danielvail44/Cubesat-Reaction-Wheel/README.md

# Cubesat-Reaction-Wheel
Low Cost Cubesat Reaction Wheel
