danielvail44/Cubesat-Reaction-Wheel/RW_board/RW_board_BOM.xlsx

Reference | Value | Datasheet | Footprint | Qty | Order Qty | Manufacturer_Part_Number | Mouser Part Number | Voltage rating | DKPN | Alt Link | Cart Links
C201,C202,C211,C212,C213 | 10u | ~ | Capacitor_SMD:C_0603_1608Metric | 5 | 15 | GRM188R6YA106MA73D | 81-GRM188R6YA106MA3D | 35V | 490-13248-1-ND | . | https://www.mouser.com/ProjectManager/ProjectDetail.aspx?AccessID=6e81cea3ba
C203,C206,C214,C303,C308,C405 | 1u | ~ | Capacitor_SMD:C_0402_1005Metric | 6 | 18 | GRM155R6YA105KE11J | 81-GRM155R6YA105KE1J | 35V | 490-GRM155R6YA105KE11JCT-ND | . | https://www.digikey.com/short/zz49hznb
C204,C207,C210,C215,C216,C217,C218,C305,C307,C401,C407,C408,C409,C410 | 100n | ~ | Capacitor_SMD:C_0402_1005Metric | 14 | 42 | GRM155R61H104KE19J | 81-GRM155R61H104KE9J | 35V | 490-GRM155R61H104KE19JCT-ND | .
C205 | 10n | ~ | Capacitor_SMD:C_0402_1005Metric | 1 | 10 | GCM155R71H103KA55J | 81-GCM155R71H103KA5J | 35V | 490-13295-1-ND | .
C208 | 1n | ~ | Capacitor_SMD:C_0402_1005Metric | 1 | 10 | GCM1555C1H102GA16J | 81-GCM1555C1H102GA6J | 35V | 490-GCM1555C1H102GA16JCT-ND | .
C209 | 10p | ~ | Capacitor_SMD:C_0402_1005Metric | 1 | 10 | GCM1555C1H100JA16D | 81-GCM1555C1H100JA6D | 35V | 490-10668-1-ND | .
C219,C406 | 4.7u | ~ | Capacitor_SMD:C_0402_1005Metric | 2 | 10 | GRM155R61A475MEAAD | 81-GRM155R61A475MEAD | 35V | 490-14306-1-ND | .
C301,C302,C304,C309 | 22uF | ~ | Capacitor_SMD:C_0805_2012Metric | 4 | 12 | C2012X5R1V226M125AC | 810-C2012X5R1V226MAC | 35V | 445-14428-1-ND | .
C306 | 47n | ~ | Capacitor_SMD:C_0402_1005Metric | 1 | 10 | GRM155R61H473KE19D | 81-GRM155R61H473KE9D | 35V | 490-12705-1-ND | .
C402 | 4.7n | ~ | Capacitor_SMD:C_0402_1005Metric | 1 | 10 | GRM155R71H472JA01D | 81-GRM155R71H472JA1D | 35V | 490-7764-1-ND | .
C403,C404 | 20p | ~ | Capacitor_SMD:C_0402_1005Metric | 2 | 10 | GRM1555C1H200JA01D | 81-GRM1555C1H200JA1D |  | 490-5930-1-ND | .
D201 | SDM2U30CSP-7 | https://www.diodes.com//assets/Datasheets/SDM2U30CSP.pdf | X3-WLB1608-2 | 1 | 2 | SDM2U30CSP-7 | 621-SDM2U30CSP-7 |  | SDM2U30CSP-7DICT-ND | .
D301 | BLUE | ~ | LED_SMD:LED_0603_1608Metric | 1 | 3 | 475-KBEELP41.12-P1R2-36-3X4X-5-R18CT-ND | 720-P4112P1R2363X4X5 |  | 475-KBEELP41.12-P1R2-36-3X4X-5-R18CT-ND | .
D302 | GREEN | ~ | LED_SMD:LED_0603_1608Metric | 1 | 3 | KT EELP41.12-S2U1-25-2X4X-5-R18 | 720-P4112S2U1252X4X5 |  | 475-KTEELP41.12-S2U1-25-2X4X-5-R18CT-ND | .
D303,D402 | YELLOW | ~ | LED_SMD:LED_0603_1608Metric | 2 | 3 | KY EELP41.22 Q2T1-36-A8J8-020-R18 | 720-P412Q2T136A8J802 |  | 475-KYEELP41.22Q2T1-36-A8J8-020-R18CT-ND | .
D304 | RED | ~ | LED_SMD:LED_0603_1608Metric | 1 | 3 | KS EELP41.22-P1R2-58-A8J8-020-R18 | 720-P412P1R258A8J802 |  | 475-KSEELP41.22-P1R2-58-A8J8-020-R18CT-ND | .
D401,D403 | PRTR5V0U2X,215 | https://assets.nexperia.com/documents/data-sheet/PRTR5V0U2X.pdf | PRTR5V0U2X | 2 | 4 | PRTR5V0U2X,215 | 771-PRTR5V0U2X-T/R |  | 1727-3884-1-ND | .
IC201 | MAX44284WAUT+T | https://datasheets.maximintegrated.com/en/ds/MAX44284.pdf | SOT95P280X145-6N | 1 | 2 | MAX44284WAUT+T | 700-MAX44284WAUT+T |  | 175-MAX44284WAUT+TCT-ND | .
IC301 | MCT8316Z0RQRGFRQ1 | https://www.ti.com/lit/ds/symlink/mct8316z-q1.pdf?ts=1673673589164 | QFN50P500X700X100-41N-D | 1 | 2 | MCT8316Z0RQRGFRQ1 | 595-CT8316Z0RQRGFRQ1 |  | 296-MCT8316Z0RQRGFRQ1CT-ND | .
J1 | Conn_01x08_Pin | ~ | Connector_Molex:Molex_PicoBlade_53048-0810_1x08_P1.25mm_Horizontal | 1 | 2 | 53048-0810 | 538-53048-0810 |  | WM1748-ND | .
J2 | 1-84953-1 | https://www.te.com/commerce/DocumentDelivery/DDEController?Action=showdoc | 1849531 | 1 | 2 | 1-84953-1 | 571-1-84953-1 |  | A101403CT-ND | .
J401 | USB4105-GF-A |  | RW_Imports:GCT_USB4105-GF-A | 1 | 2 | USB4105-GF-A | 640-USB4105-GF-A |  | 2073-USB4105-GF-ACT-ND | .
J402 | 20021521-00010T4LF | https://cdn.amphenol-cs.com/media/wysiwyg/files/drawing/20021521.pdf | 2002152100010T4LF | 1 | 2 | 20021521-00010T4LF | 649-221521-00010T4LF |  | 609-6534-ND | .
L301 | BCL322515RT-470M-D | https://product.tdk.com/system/files/dam/doc/product/inductor/inductor/smd/catalog/inductor_automotive_power_bcl322515rt-d_en.pdf | RW_Imports:INDPM3225X150N | 1 | 2 | BCL322515RT-470M-D | 810-BCL322515RT470MD |  | 445-BCL322515RT-470M-DCT-ND | .
R1 | 20 | ~ | Resistor_SMD:R_0402_1005Metric | 1 | 10 | 560112110083 | 710-560112110083 |  | 732-560112110083CT-ND | .
R101,R202,R305,R308,R402 | 10k | ~ | Resistor_SMD:R_0402_1005Metric | 5 | 15 | 560112110020 | 710-560112110020 |  | 732-560112110020CT-ND | .
R102,R212,R214,R408 | 1k | ~ | Resistor_SMD:R_0402_1005Metric | 4 | 12 | 560112110012 | 710-560112110012 |  | 732-560112110012CT-ND | .
R201 | 16k | ~ | Resistor_SMD:R_0402_1005Metric | 1 | 10 | 560112110032 | 710-560112110032 |  | 732-560112110032CT-ND | .
R203 | 3.01k | ~ | Resistor_SMD:R_0402_1005Metric | 1 | 10 | CRT0402-FZ-3011GLF | 652-CRT0402FZ3011GLF |  | 311-3.01KLRCT-ND | .
R204 | 1.1k | ~ | Resistor_SMD:R_0402_1005Metric | 1 | 10 | 560112110185 | 710-560112110185 |  | 732-560112110185CT-ND | .
R205 | 6.9k | ~ | Resistor_SMD:R_0402_1005Metric | 1 | 10 | RT0402BRD076K9L | 71-TNPW04026K90BEED |  | 541-4510-1-ND | .
R206 | 100 | ~ | Resistor_SMD:R_0402_1005Metric | 1 | 10 | 560112110022 | 710-560112110022 |  | 732-560112110022CT-ND | .
R207 | 390m | ~ | Resistor_SMD:R_0805_2012Metric | 1 | 10 | RL1220S-R39-F | 754-RL1220S-R39-F |  | RL12S.39FCT-ND | .
R208,R210 | 24k | ~ | Resistor_SMD:R_0402_1005Metric | 2 | 10 | 560112110178 | 710-560112110178 |  | 311-24KJRCT-ND | .
R209 | 1.33k | ~ | Resistor_SMD:R_0402_1005Metric | 1 | 10 | CRT0402-FZ-1331GLF | 652-CRT0402FZ1331GLF |  | 311-1.33KLRCT-ND | .
R211 | 3.65k | ~ | Resistor_SMD:R_0402_1005Metric | 1 | 10 | 560112110116 | 710-560112110116 |  | 732-560112110116CT-ND | .
R213 | 20m | ~ | Resistor_SMD:R_0603_1608Metric | 1 | 10 | PE0603DRF570R02L | 603-PE0603DRF570R02L |  | 13-PE0603DRF570R02LCT-ND | .
R302,R303,R304,R401,R405 | 5.1k | ~ | Resistor_SMD:R_0402_1005Metric | 5 | 15 | CR0402-FX-5101GLF | 652-CR0402FX-5101GLF |  | CR0402-FX-5101GLFCT-ND | .
R306,R307,R309,R403,R406 | 330R | ~ | Resistor_SMD:R_0402_1005Metric | 5 | 15 | 560112110231 | 710-560112110231 |  | 732-560112110231CT-ND | .
R404 | 1M | ~ | Resistor_SMD:R_0402_1005Metric | 1 | 10 | 560112110033 | 710-560112110033 |  | 732-560112110033CT-ND | .
R407 | 39R | ~ | Resistor_SMD:R_0402_1005Metric | 1 | 10 | 560112110014 | 710-560112110014 |  | 732-560112110014CT-ND | .
SW401 | SW_Push | ~ | Button_Switch_SMD:SW_SPST_FSMSM | 1 | 2 | RS282G05A3SMRT | 611-RS-282G05A3-SMRT |  | CKN10384CT-ND | .
U201 | LM5022MM | http://www.ti.com/lit/ds/symlink/lm5022.pdf | Package_SO:MSOP-10_3x3mm_P0.5mm | 1 | 2 | LM5022MMX/NOPB | 926-LM5022MMX/NOPB |  | 296-LM5022MMX/NOPBCT-ND | .
U401 | ATSAMD21G18A-M | http://ww1.microchip.com/downloads/en/DeviceDoc/SAM_D21_DA1_Family_Data%20Sheet_DS40001882E.pdf | Package_DFN_QFN:QFN-48-1EP_7x7mm_P0.5mm_EP5.15x5.15mm | 1 | 2 | ATSAMD21G18A-MUT | 556-ATSAMD21G18A-MUT |  | ATSAMD21G18A-MUTCT-ND | .
Y401 | 830105946101 | https://www.mouser.tw/datasheet/2/445/830105946101-2005497.pdf | 830105946101 | 1 | 2 | 830105946101 | 710-830105946101 |  | 1923-830105946101CT-ND | .
L201 | XGL4040-223MEC |  | RW_Imports:IND_XGL4040-223MEC | 1 | 2 | XGL4040-223 |  |  | 2457-XGL4040-223MEC-ND | https://www.coilcraft.com/en-us/products/power/shielded-inductors/molded-inductor/xgl/xgl4040/xgl4040-223/
Q201 | BSZ300N15NS5ATMA1 | https://www.arrow.com/en/products/bsz300n15ns5atma1/infineon-technologies-ag | BSZ300N15NS5ATMA1 | 1 | 2 | BSZ300N15NS5ATMA1 |  |  | BSZ300N15NS5ATMA1CT-ND | https://www.rocelec.com/part/01tRl000007YmmJIAS-NCP1117DT12RKG
