danielvail44/Cubesat-Reaction-Wheel/CAD/ECX flat 22.stp

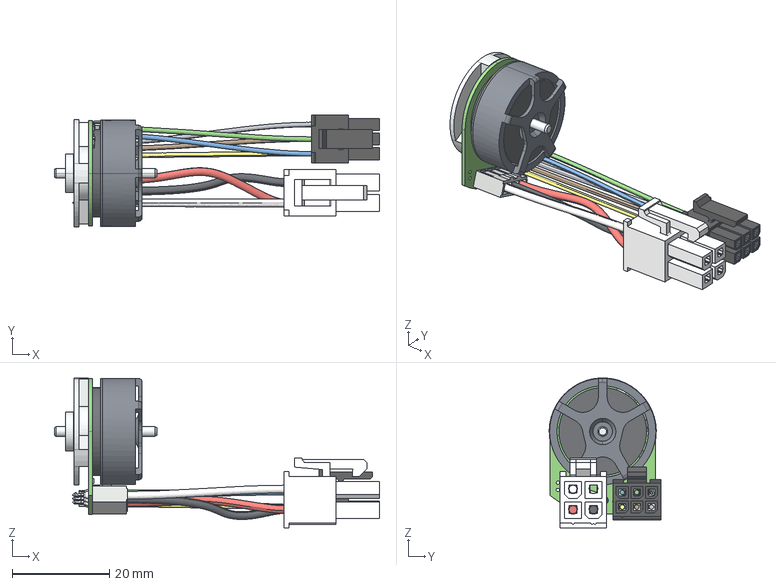
[picture p1: CAD file, 2025-01-22]
CAD/ECX flat 22.stp
66.7 x 22.9 x 30.8 mm
