danielvail44/Cubesat-Reaction-Wheel/(list of files, cad)

Other CAD files:
CAD/motor_pcb_drawing.dwg
CAD/OldVersions/motor_drawing.0001.dwg
