danielvail44/Cubesat-Reaction-Wheel/RW_board/RW_board.kicad_pcb

## KiCad design RW_board/RW_board.kicad_pcb (2025-02-06)

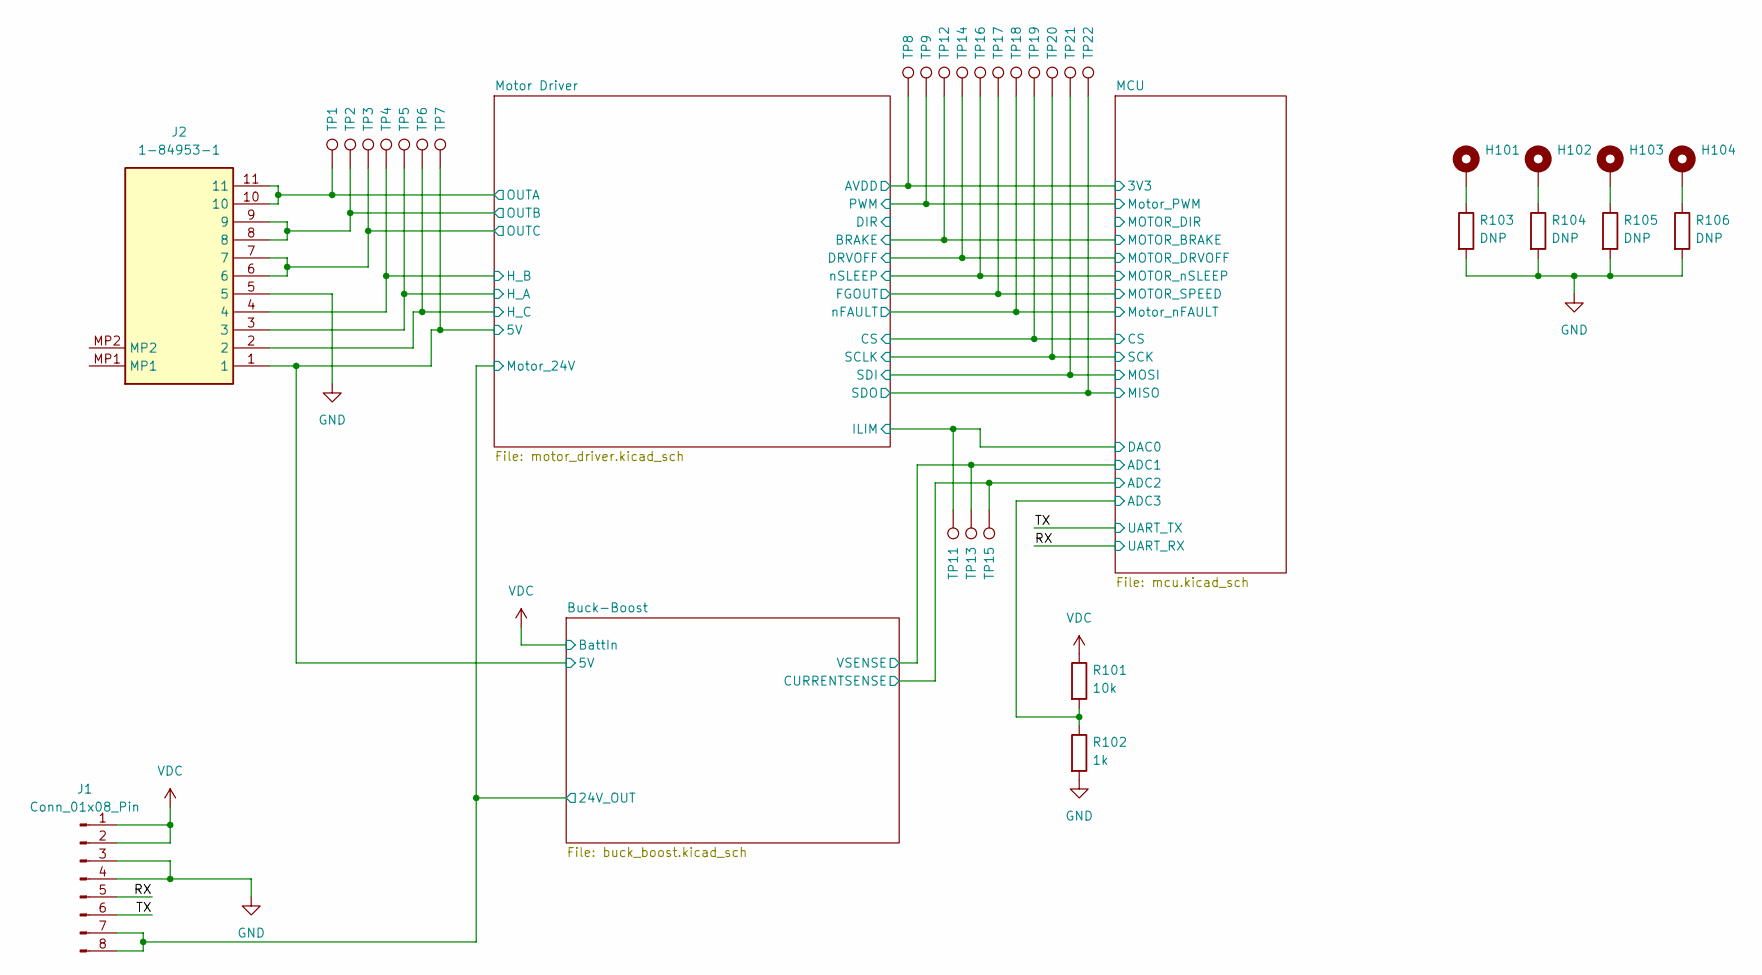
[picture p2: schematic RW_board.kicad_sch]

Parts:
H101, H102, H103, H104: MountingHole_Pad; MountingHole_3.4mm_Pad
J1: Conn_01x08_Pin; Molex_PicoBlade_53048-0810_1x08_P1.25mm_Horizontal; Mouser Part Number 538-53048-0810
J2: 1-84953-1; 1849531; Mouser Part Number 571-1-84953-1
R101: 10k; R_0402_1005Metric; Mouser Part Number 710-560112110020
R102: 1k; R_0402_1005Metric; Mouser Part Number 710-560112110012
R103, R104, R105, R106: DNP; R_0402_1005Metric
TP1, TP2, TP3, TP4, TP5, TP6, TP7, TP8, TP9, TP11, TP12, TP13, TP14, TP15, TP16, TP17, TP18, TP19, TP20, TP21, TP22: TestPoint; TestPoint_Pad_1.0x1.0mm

Connections:
+3.3V: TP8.1; also elsewhere on the board
/Buck-Boost/24V_OUT: J1.7, J1.8; also elsewhere on the board
/Buck-Boost/CURRENTSENSE: TP15.1; also elsewhere on the board
/Buck-Boost/VSENSE: TP13.1; also elsewhere on the board
/MCU/ADC3: R101.2, R102.1; also elsewhere on the board
/MCU/CS: TP19.1; also elsewhere on the board
/MCU/DAC0: TP11.1; also elsewhere on the board
/MCU/MISO: TP22.1; also elsewhere on the board
/MCU/MOSI: TP21.1; also elsewhere on the board
/MCU/MOTOR_BRAKE: TP12.1; also elsewhere on the board
/MCU/MOTOR_DRVOFF: TP14.1; also elsewhere on the board
/MCU/MOTOR_SPEED: TP17.1; also elsewhere on the board
/MCU/MOTOR_nSLEEP: TP16.1; also elsewhere on the board
/MCU/Motor_PWM: TP9.1; also elsewhere on the board
/MCU/Motor_nFAULT: TP18.1; also elsewhere on the board
/MCU/SCK: TP20.1; also elsewhere on the board
/Motor Driver/FB_BK: J2.1, TP7.1; also elsewhere on the board
/Motor Driver/H_A: J2.3, TP5.1; also elsewhere on the board
/Motor Driver/H_B: J2.4, TP4.1; also elsewhere on the board
/Motor Driver/H_C: J2.2, TP6.1; also elsewhere on the board
/Motor Driver/OUTA: J2.10, J2.11, TP1.1; also elsewhere on the board
/Motor Driver/OUTB: J2.8, J2.9, TP2.1; also elsewhere on the board
/Motor Driver/OUTC: J2.6, J2.7, TP3.1; also elsewhere on the board
/RX: J1.5; also elsewhere on the board
/TX: J1.6; also elsewhere on the board
GND: J1.3, J1.4, J2.5, R102.2, R103.2, R104.2, R105.2, R106.2; also elsewhere on the board
unnamed: H101.1, R103.1
unnamed: H102.1, R104.1
unnamed: H103.1, R105.1
unnamed: H104.1, R106.1
VDC: J1.1, J1.2, R101.1; also elsewhere on the board

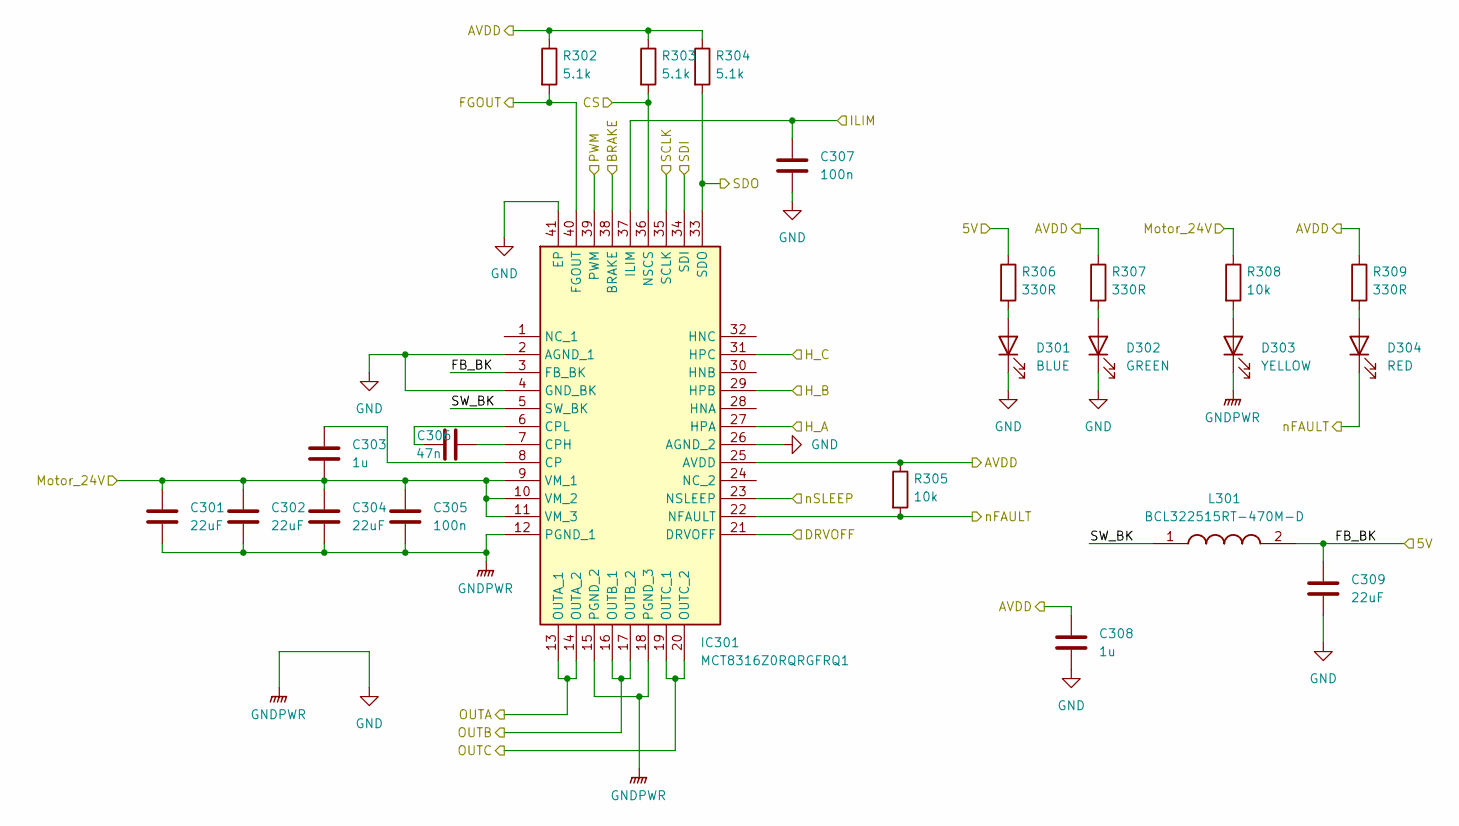
[picture p3: schematic motor_driver.kicad_sch]

Parts:
C301, C302, C304, C309: 22uF; C_0805_2012Metric; Voltage rating 35V; Mouser Part Number 810-C2012X5R1V226MAC
C303, C308: 1u; C_0402_1005Metric; Voltage rating 35V; Mouser Part Number 81-GRM155R6YA105KE1J
C305, C307: 100n; C_0402_1005Metric; Voltage rating 35V; Mouser Part Number 81-GRM155R61H104KE9J
C306: 47n; C_0402_1005Metric; Voltage rating 35V; Mouser Part Number 81-GRM155R61H473KE9D
D301: BLUE; LED_0603_1608Metric; Mouser Part Number 720-P4112P1R2363X4X5
D302: GREEN; LED_0603_1608Metric; Mouser Part Number 720-P4112S2U1252X4X5
D303: YELLOW; LED_0603_1608Metric; Mouser Part Number 720-P412Q2T136A8J802
D304: RED; LED_0603_1608Metric; Mouser Part Number 720-P412P1R258A8J802
IC301: MCT8316Z0RQRGFRQ1; QFN50P500X700X100-41N-D; Mouser Part Number 595-CT8316Z0RQRGFRQ1
L301: BCL322515RT-470M-D; INDPM3225X150N; Mouser Part Number 810-BCL322515RT470MD
R302, R303, R304: 5.1k; R_0402_1005Metric; Mouser Part Number 652-CR0402FX-5101GLF
R305, R308: 10k; R_0402_1005Metric; Mouser Part Number 710-560112110020
R306, R307, R309: 330R; R_0402_1005Metric; Mouser Part Number 710-560112110231

Connections:
+3.3V: C308.1, IC301.25 (AVDD), R302.1, R303.1, R304.1, R305.1, R307.1, R309.1; also elsewhere on the board
/Buck-Boost/24V_OUT: C301.1, C302.1, C303.2, C304.1, C305.1, IC301.9 (VM_1), IC301.10 (VM_2), IC301.11 (VM_3), R308.1; also elsewhere on the board
/MCU/CS: IC301.36 (NSCS), R303.2; also elsewhere on the board
/MCU/DAC0: C307.1, IC301.37 (ILIM); also elsewhere on the board
/MCU/MISO: IC301.33 (SDO), R304.2; also elsewhere on the board
/MCU/MOSI: IC301.34 (SDI); also elsewhere on the board
/MCU/MOTOR_BRAKE: IC301.38 (BRAKE); also elsewhere on the board
/MCU/MOTOR_DRVOFF: IC301.21 (DRVOFF); also elsewhere on the board
/MCU/MOTOR_SPEED: IC301.40 (FGOUT), R302.2; also elsewhere on the board
/MCU/MOTOR_nSLEEP: IC301.23 (NSLEEP); also elsewhere on the board
/MCU/Motor_PWM: IC301.39 (PWM); also elsewhere on the board
/MCU/Motor_nFAULT: D304.1 (K), IC301.22 (NFAULT), R305.2; also elsewhere on the board
/MCU/SCK: IC301.35 (SCLK); also elsewhere on the board
/Motor Driver/FB_BK: C309.1, IC301.3 (FB_BK), L301.2, R306.1; also elsewhere on the board
/Motor Driver/H_A: IC301.27 (HPA); also elsewhere on the board
/Motor Driver/H_B: IC301.29 (HPB); also elsewhere on the board
/Motor Driver/H_C: IC301.31 (HPC); also elsewhere on the board
/Motor Driver/OUTA: IC301.13 (OUTA_1), IC301.14 (OUTA_2); also elsewhere on the board
/Motor Driver/OUTB: IC301.16 (OUTB_1), IC301.17 (OUTB_2); also elsewhere on the board
/Motor Driver/OUTC: IC301.19 (OUTC_1), IC301.20 (OUTC_2); also elsewhere on the board
/Motor Driver/SW_BK: IC301.5 (SW_BK), L301.1
GND: C301.2, C302.2, C304.2, C305.2, C307.2, C308.2, C309.2, D301.1 (K), D302.1 (K), D303.1 (K), IC301.2 (AGND_1), IC301.4 (GND_BK), IC301.12 (PGND_1), IC301.15 (PGND_2), IC301.18 (PGND_3), IC301.26 (AGND_2), IC301.41 (EP); also elsewhere on the board
unnamed: D301.2 (A), R306.2
unnamed: D302.2 (A), R307.2
unnamed: D303.2 (A), R308.2
unnamed: D304.2 (A), R309.2
unnamed: C303.1, IC301.8 (CP)
unnamed: C306.2, IC301.7 (CPH)
unnamed: C306.1, IC301.6 (CPL)

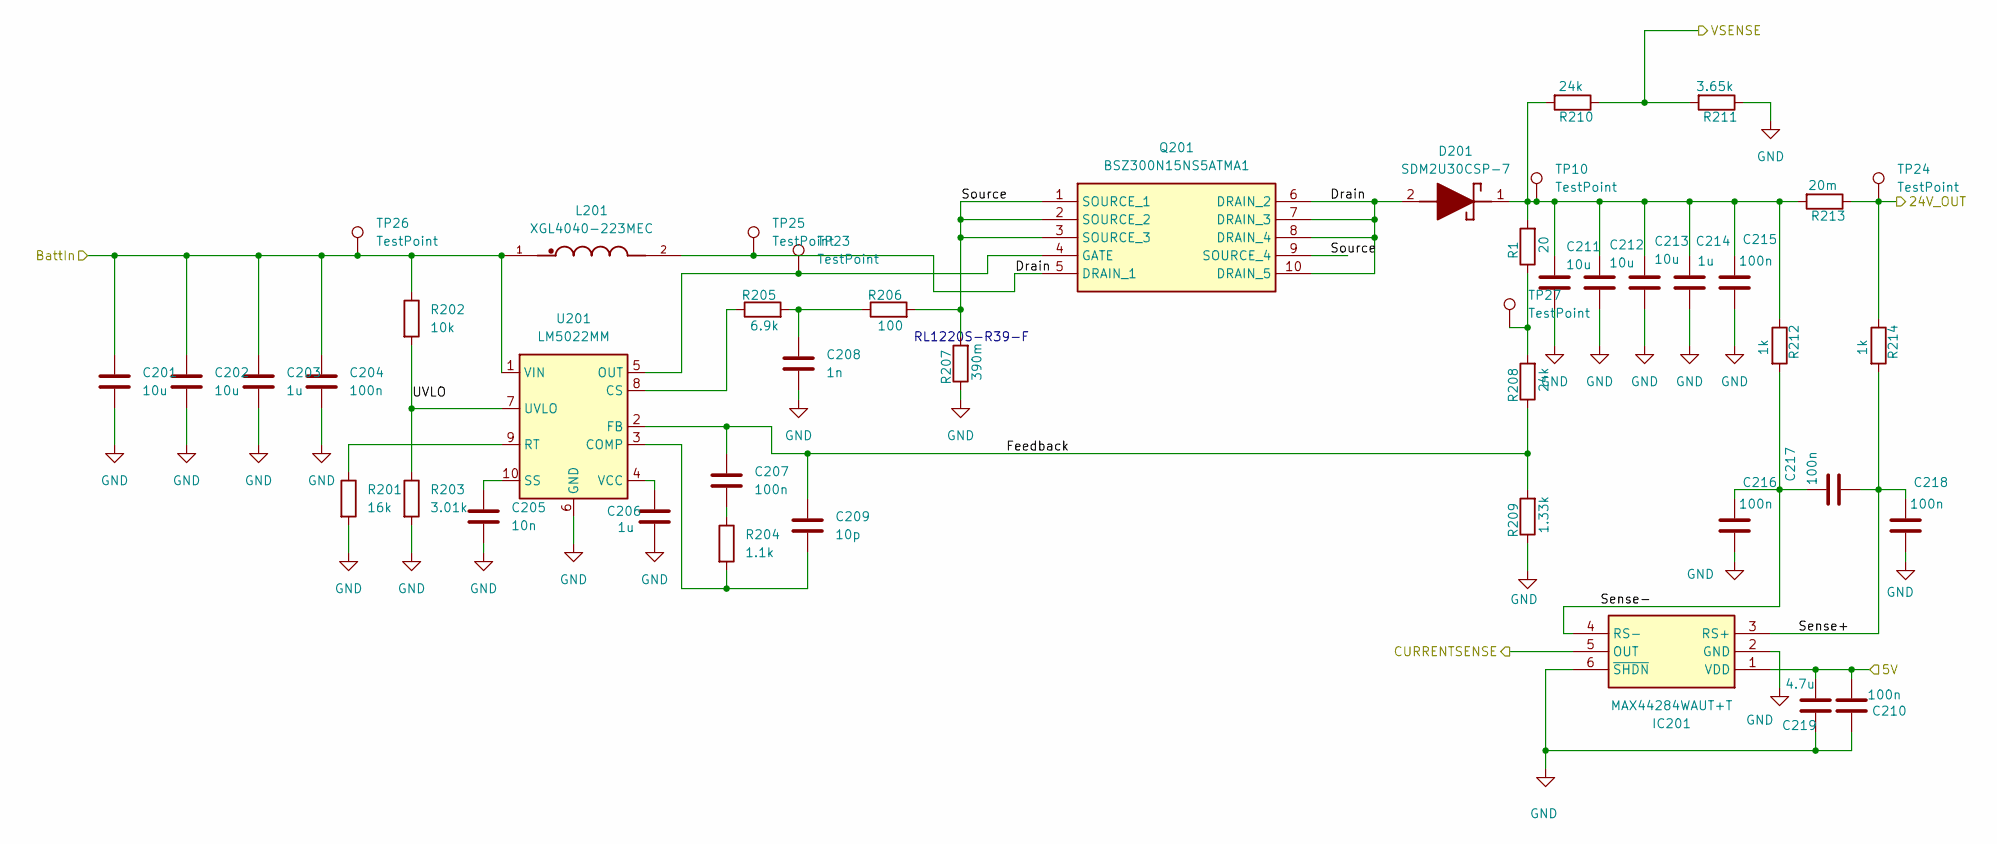
[picture p4: schematic buck_boost.kicad_sch]

Parts:
C201, C202, C211, C212, C213: 10u; C_0603_1608Metric; Voltage rating 35V; Mouser Part Number 81-GRM188R6YA106MA3D
C203, C206, C214: 1u; C_0402_1005Metric; Voltage rating 35V; Mouser Part Number 81-GRM155R6YA105KE1J
C204, C207, C210, C215, C216, C217, C218: 100n; C_0402_1005Metric; Voltage rating 35V; Mouser Part Number 81-GRM155R61H104KE9J
C205: 10n; C_0402_1005Metric; Voltage rating 35V; Mouser Part Number 81-GCM155R71H103KA5J
C208: 1n; C_0402_1005Metric; Voltage rating 35V; Mouser Part Number 81-GCM1555C1H102GA6J
C209: 10p; C_0402_1005Metric; Voltage rating 35V; Mouser Part Number 81-GCM1555C1H100JA6D
C219: 4.7u; C_0402_1005Metric; Voltage rating 35V; Mouser Part Number 81-GRM155R61A475MEAD
D201: SDM2U30CSP-7; X3-WLB1608-2; Mouser Part Number 621-SDM2U30CSP-7
IC201: MAX44284WAUT+T; SOT95P280X145-6N; Mouser Part Number 700-MAX44284WAUT+T
L201: XGL4040-223MEC; IND_XGL4040-223MEC; PARTREV 10/08/21
Q201: BSZ300N15NS5ATMA1; Mouser Part Number 726-BSZ300N15NS5ATMA
R1: 20; R_0402_1005Metric; Mouser Part Number 710-560112110083
R201: 16k; R_0402_1005Metric; Mouser Part Number 710-560112110032
R202: 10k; R_0402_1005Metric; Mouser Part Number 710-560112110020
R203: 3.01k; R_0402_1005Metric; Mouser Part Number 652-CRT0402FZ3011GLF
R204: 1.1k; R_0402_1005Metric; Mouser Part Number 710-560112110185
R205: 6.9k; R_0402_1005Metric; Mouser Part Number 603-RT0402BRD076K9L
R206: 100; R_0402_1005Metric; Mouser Part Number 710-560112110022
R207: 390m; R_0805_2012Metric; Manufacturer_Part_Number RL1220S-R39-F; Mouser Part Number 754-RL1220S-R39-F
R208, R210: 24k; R_0402_1005Metric; Mouser Part Number 710-560112110178
R209: 1.33k; R_0402_1005Metric; Mouser Part Number 652-CRT0402FZ1331GLF
R211: 3.65k; R_0402_1005Metric; Mouser Part Number 710-560112110116
R212, R214: 1k; R_0402_1005Metric; Mouser Part Number 710-560112110012
R213: 20m; R_0603_1608Metric; Mouser Part Number 603-PE0603DRF570R02L
TP10, TP23, TP24, TP25, TP26, TP27: TestPoint; TestPoint_Pad_1.0x1.0mm
U201: LM5022MM; MSOP-10_3x3mm_P0.5mm; Mouser Part Number 926-LM5022MMX/NOPB

Connections:
/Buck-Boost/24V_OUT: R213.1, R214.1, TP24.1; also elsewhere on the board
/Buck-Boost/CURRENTSENSE: IC201.5 (OUT); also elsewhere on the board
/Buck-Boost/Drain: D201.2 (A), L201.2, Q201.5 (DRAIN_1), Q201.6 (DRAIN_2), Q201.7 (DRAIN_3), Q201.8 (DRAIN_4), Q201.10 (DRAIN_5), TP25.1
/Buck-Boost/Feedback: C207.1, C209.1, R208.1, R209.2, U201.2 (FB)
/Buck-Boost/Sense+: C217.2, C218.1, IC201.3 (RS+), R214.2
/Buck-Boost/Sense-: C216.1, C217.1, IC201.4 (RS-), R212.2
/Buck-Boost/Source: Q201.1 (SOURCE_1), Q201.2 (SOURCE_2), Q201.3 (SOURCE_3), Q201.9 (SOURCE_4), R206.2, R207.2
/Buck-Boost/UVLO: R202.2, R203.1, U201.7 (UVLO)
/Buck-Boost/VSENSE: R210.1, R211.2; also elsewhere on the board
/Motor Driver/FB_BK: C210.2, C219.2, IC201.1 (VDD); also elsewhere on the board
GND: C201.2, C202.2, C203.2, C204.2, C205.2, C206.2, C208.2, C210.1, C211.2, C212.2, C213.2, C214.2, C215.2, C216.2, C218.2, C219.1, IC201.2 (GND), IC201.6 (~SHDN), R201.2, R203.2, R207.1, R209.1, R211.1, U201.6 (GND); also elsewhere on the board
unnamed: C207.2, R204.1
unnamed: C208.1, R205.2, R206.1
unnamed: C211.1, C212.1, C213.1, C214.1, C215.1, D201.1 (K), R1.2, R210.2, R212.1, R213.2, TP10.1
unnamed: Q201.4 (GATE), TP23.1, U201.5 (OUT)
unnamed: R1.1, R208.2, TP27.1
unnamed: C209.2, R204.2, U201.3 (COMP)
unnamed: R205.1, U201.8 (CS)
unnamed: R201.1, U201.9 (RT)
unnamed: C205.1, U201.10 (SS)
unnamed: C206.1, U201.4 (VCC)
VDC: C201.1, C202.1, C203.1, C204.1, L201.1, R202.1, TP26.1, U201.1 (VIN); also elsewhere on the board

Notes on the sheet:
RL1220S-R39-F

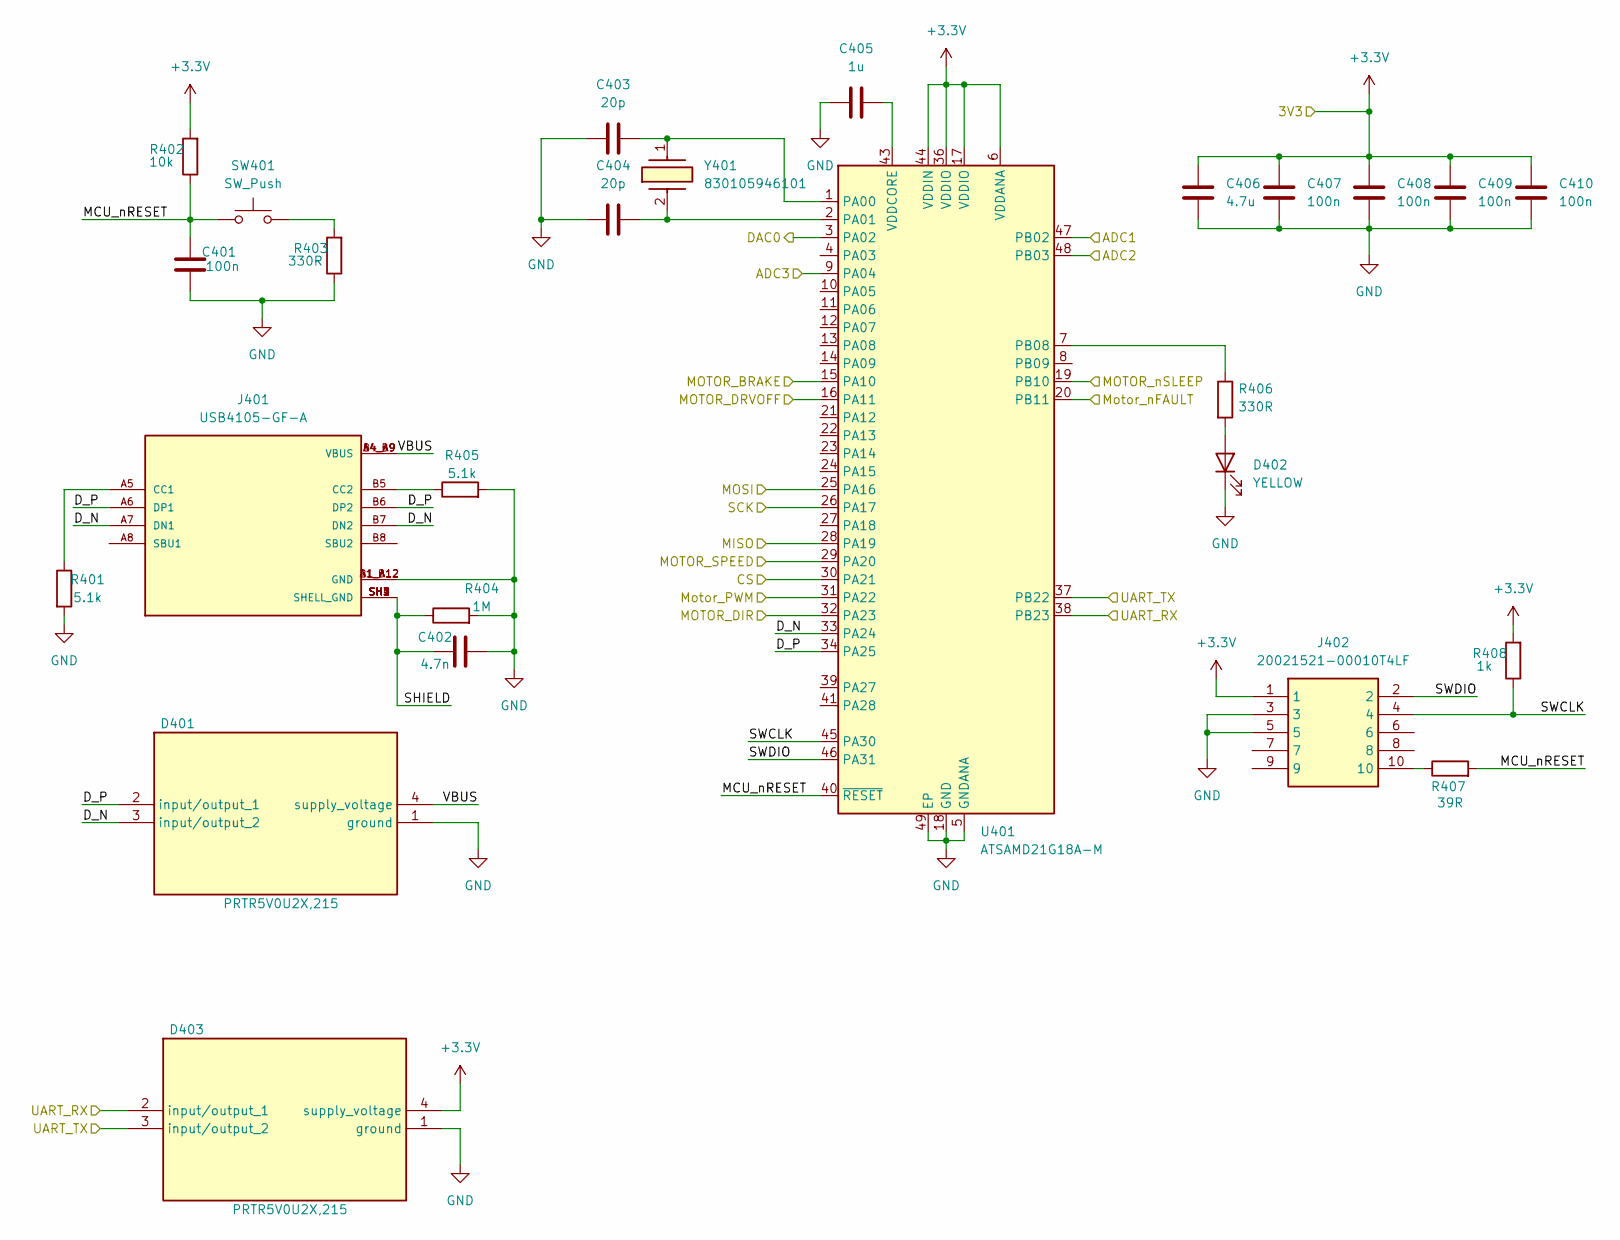
[picture p5: schematic mcu.kicad_sch]

Parts:
C401, C407, C408, C409, C410: 100n; C_0402_1005Metric; Voltage rating 35V; Mouser Part Number 81-GRM155R61H104KE9J
C402: 4.7n; C_0402_1005Metric; Voltage rating 35V; Mouser Part Number 81-GRM155R71H472JA1D
C403, C404: 20p; C_0402_1005Metric; Mouser Part Number 81-GRM1555C1H200JA1D
C405: 1u; C_0402_1005Metric; Voltage rating 35V; Mouser Part Number 81-GRM155R6YA105KE1J
C406: 4.7u; C_0402_1005Metric; Voltage rating 35V; Mouser Part Number 81-GRM155R61A475MEAD
D401, D403: PRTR5V0U2X,215; PRTR5V0U2X; Mouser Part Number 771-PRTR5V0U2X-T/R
D402: YELLOW; LED_0603_1608Metric; Mouser Part Number 720-P412Q2T136A8J802
J401: USB4105-GF-A; GCT_USB4105-GF-A; PARTREV B4; Mouser Part Number 640-USB4105-GF-A
J402: 20021521-00010T4LF; 2002152100010T4LF; Mouser Part Number 649-221521-00010T4LF
R401, R405: 5.1k; R_0402_1005Metric; Mouser Part Number 652-CR0402FX-5101GLF
R402: 10k; R_0402_1005Metric; Mouser Part Number 710-560112110020
R403, R406: 330R; R_0402_1005Metric; Mouser Part Number 710-560112110231
R404: 1M; R_0402_1005Metric; Mouser Part Number 710-560112110033
R407: 39R; R_0402_1005Metric; Mouser Part Number 710-560112110014
R408: 1k; R_0402_1005Metric; Mouser Part Number 710-560112110012
SW401: SW_Push; SW_SPST_FSMSM; Mouser Part Number 611-RS-282G05A3-SMRT
U401: ATSAMD21G18A-M; QFN-48-1EP_7x7mm_P0.5mm_EP5.15x5.15mm; Mouser Part Number 556-ATSAMD21G18A-MUT
Y401: 830105946101; Mouser Part Number 710-830105946101

Connections:
+3.3V: C406.2, C407.2, C408.2, C409.2, C410.2, D403.4 (supply_voltage), J402.1, R402.2, R408.2, U401.6 (VDDANA), U401.17 (VDDIO), U401.36 (VDDIO), U401.44 (VDDIN); also elsewhere on the board
/Buck-Boost/CURRENTSENSE: U401.48 (PB03); also elsewhere on the board
/Buck-Boost/VSENSE: U401.47 (PB02); also elsewhere on the board
/MCU/ADC3: U401.9 (PA04); also elsewhere on the board
/MCU/CS: U401.30 (PA21); also elsewhere on the board
/MCU/DAC0: U401.3 (PA02); also elsewhere on the board
/MCU/D_N: D401.3 (input/output_2), J401.A7 (DN1), J401.B7 (DN2), U401.33 (PA24)
/MCU/D_P: D401.2 (input/output_1), J401.A6 (DP1), J401.B6 (DP2), U401.34 (PA25)
/MCU/MCU_nRESET: C401.2, R402.1, R407.2, SW401.1, U401.40 (~RESET)
/MCU/MISO: U401.28 (PA19); also elsewhere on the board
/MCU/MOSI: U401.25 (PA16); also elsewhere on the board
/MCU/MOTOR_BRAKE: U401.15 (PA10); also elsewhere on the board
/MCU/MOTOR_DIR: U401.32 (PA23)
/MCU/MOTOR_DRVOFF: U401.16 (PA11); also elsewhere on the board
/MCU/MOTOR_SPEED: U401.29 (PA20); also elsewhere on the board
/MCU/MOTOR_nSLEEP: U401.19 (PB10); also elsewhere on the board
/MCU/Motor_PWM: U401.31 (PA22); also elsewhere on the board
/MCU/Motor_nFAULT: U401.20 (PB11); also elsewhere on the board
/MCU/SCK: U401.26 (PA17); also elsewhere on the board
/MCU/SHIELD: C402.1, J401.SH1 (SHELL_GND), J401.SH2 (SHELL_GND), J401.SH3 (SHELL_GND), J401.SH4 (SHELL_GND), R404.1
/MCU/SWCLK: J402.4, R408.1, U401.45 (PA30)
/MCU/SWDIO: J402.2, U401.46 (PA31)
/MCU/VBUS: D401.4 (supply_voltage), J401.A4_B9 (VBUS), J401.B4_A9 (VBUS)
/RX: D403.2 (input/output_1), U401.38 (PB23); also elsewhere on the board
/TX: D403.3 (input/output_2), U401.37 (PB22); also elsewhere on the board
GND: C401.1, C402.2, C403.1, C404.1, C405.1, C406.1, C407.1, C408.1, C409.1, C410.1, D401.1 (ground), D402.1 (K), D403.1 (ground), J401.A1_B12 (GND), J401.B1_A12 (GND), J402.3, J402.5, R401.2, R403.1, R404.2, R405.2, U401.5 (GNDANA), U401.18 (GND), U401.35 (GND), U401.42 (GND), U401.49 (EP); also elsewhere on the board
unnamed: D402.2 (A), R406.2
unnamed: J401.A5 (CC1), R401.1
unnamed: J401.B5 (CC2), R405.1
unnamed: J402.10, R407.1
unnamed: R403.2, SW401.2
unnamed: C403.2, U401.1 (PA00), Y401.1
unnamed: C404.2, U401.2 (PA01), Y401.2 (CRYSTAL_2)
unnamed: R406.1, U401.7 (PB08)
unnamed: C405.2, U401.43 (VDDCORE)

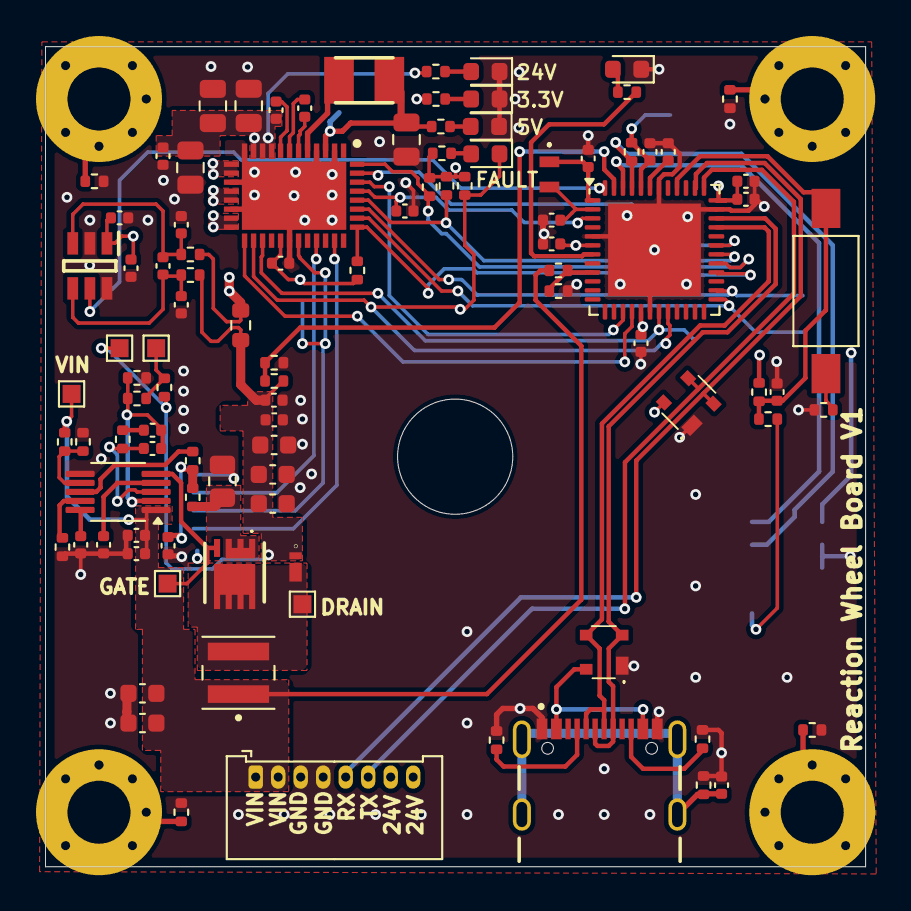
[picture p6: board RW_board.kicad_pcb from above]

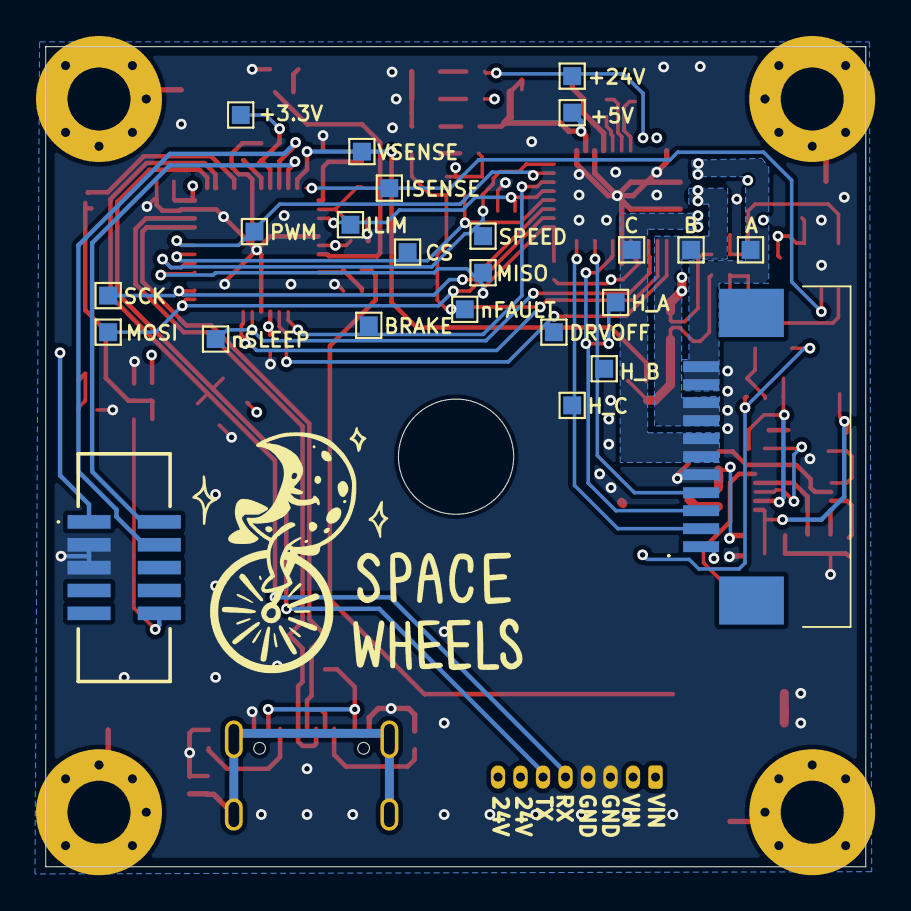
[picture p7: board RW_board.kicad_pcb from below]

Board: 4 copper layers, 45.6 x 45.6 mm, 127 parts (24 on the bottom side), 71 nets.
