danielvail44/Cubesat-Reaction-Wheel/(commit log)

2025-01-08 Started working on motor driver schematic, added libraries, added motor cad
    [RW_board.kicad_sch, mcu.kicad_sch, motor.stp, motor_drawing.0001.dwg, motor_driver.kicad_sch, motor_pcb_drawing.dwg]
2025-01-08 Added motor symbol/footprint, worked more on schematic
    [RW_board.kicad_sch, motor_driver.kicad_sch]
2025-01-10 Switched to MCT8316, added supporting components
    [motor_driver.kicad_sch]
2025-01-13 Completed motor driver schematic
    [motor_driver.kicad_sch]
2025-01-13 Revert "Completed motor driver schematic"
    This reverts commit 6eff020a4600c20233f645a88c0bbf96158f60b4.
    [motor_driver.kicad_sch]
2025-01-13 Completed MCU schematic, connected with driver schematic
    [RW_board.kicad_sch, mcu.kicad_sch, motor_driver.kicad_sch]
2025-01-20 Switched motor, added connectors, finished up design
    [ECX flat 22.stp, RW_board.kicad_sch, mcu.kicad_sch, motor.stp, motor_driver.kicad_sch]
2025-01-21 Implemented Initial Schematic of Boost Converter
    Some part values not fully defined but expected footprint added
    [buck_boost.kicad_sch]
2025-01-21 Picoblade footprint
    [RW_board.kicad_sch]
2025-01-22 Fixed reset switch
    [RW_board.kicad_sch, mcu.kicad_sch, motor_driver.kicad_sch]
2025-01-22 Fixed text
    [RW_board.kicad_sch, motor_driver.kicad_sch]
2025-01-22 Boost Converter Update: V & C Sense
    Added voltage and current sensing
    [RW_board.kicad_sch, buck_boost.kicad_sch, mcu.kicad_sch, motor_driver.kicad_sch]
2025-01-22 Added ADC inputs
    [RW_board.kicad_sch, mcu.kicad_sch, motor_driver.kicad_sch]
2025-01-24 Connected everything, added testpoints
    [RW_board.kicad_sch, buck_boost.kicad_sch, mcu.kicad_sch, motor_driver.kicad_sch]
2025-01-24 Initial board layout
    [RW_board.kicad_pcb, RW_board.kicad_sch, buck_boost.kicad_sch, mcu.kicad_sch, motor_driver.kicad_sch]
2025-01-24 Fixed some Boost sillyness
    Added Testpoints, another cap for Curr sense IC, and fixed mosfet pinout
    [RW_board.kicad_pcb, RW_board.kicad_sch, buck_boost.kicad_sch, mcu.kicad_sch, motor_driver.kicad_sch]
2025-01-24 Some more boost changes
    [RW_board.kicad_pcb, buck_boost.kicad_sch]
2025-01-25 Initial routing complete
    [RW_board.kicad_pcb, RW_board.kicad_sch, buck_boost.kicad_sch, mcu.kicad_sch, motor_driver.kicad_sch]
2025-01-29 Board complete
    [RW_board.kicad_pcb, RW_board.kicad_sch]
2025-01-29 Added logo, TVS diode, made test production files
    [RW_board.kicad_pcb, mcu.kicad_sch]
2025-01-29 via fix
    [RW_board.kicad_pcb, mcu.kicad_sch]
2025-01-30 Update mounting holes
    [RW_board.kicad_pcb]
2025-02-03 Boost Testpoint Update
    2 Testpoints added to schematic and layout
    [RW_board.kicad_pcb, RW_board.kicad_sch, buck_boost.kicad_sch, mcu.kicad_sch, motor_driver.kicad_sch]
2025-02-04 Curr Sense Edits & 24V Reroute
    [RW_board.kicad_pcb]
2025-02-04 Changed Footprints
    Hand Solder to not
    [RW_board.kicad_pcb, buck_boost.kicad_sch]
2025-02-04 Add part numbers
    [RW_board.kicad_sch, buck_boost.kicad_sch, mcu.kicad_sch, motor_driver.kicad_sch]
2025-02-05 Bom completed and generated, minor PCB adjustments
    [RW_board.kicad_pcb, RW_board.kicad_sch, buck_boost.kicad_sch, mcu.kicad_sch, motor_driver.kicad_sch]
2025-02-05 BOM excel added
    [RW_board.kicad_pcb, RW_board_BOM.xlsx]
2025-02-05 fix silkscreen
    [RW_board.kicad_pcb]
2025-02-05 Updated logo silkscreen, generated production files
    [RW_board.kicad_pcb]
2025-02-06 PCBWay production files
    [RW_board-B_Cu.gbr, RW_board-B_Mask.gbr, RW_board-B_Paste.gbr, RW_board-B_Silkscreen.gbr, RW_board-Edge_Cuts.gbr, RW_board-F_Cu.gbr, RW_board-F_Mask.gbr, RW_board-F_Paste.gbr]
